pixutian/PingPong-Ball-Collector/docs/communication.md

# Communication Protocol · 蓝牙通信协议（v0.2）

> 本文描述 `firmware/Fusion_OpenCar` 在 UART2 上**实际解析**的协议。
> 厂家 App 的完整协议以其官方文档为准，本仓库不复制该文档。

---

## 1. 物理层

| 项目 | 参数 |
|---|---|
| 接口 | C30D USART2（`PD5` TX / `PD6` RX） |
| 波特率 | 9600 |
| 数据位/停止位/校验 | 8 / 1 / None |
| 模块 | JDY-33 / HC-02 兼容经典蓝牙 SPP |
| 手机侧 | 自研 App V3.2（推荐，本仓库开源）；厂家 App 仅兼容对照 |

手机与模块之间为 SPP 透传：App 发出的字节直接进入 `USART2_IRQHandler`，经 `module_noise_filter()`
丢弃模块提示文本后进入 `link_decode()`。

---

## 2. 下行指令

### 2.1 方向与功能（单字节 ASCII）

```c
g_link_dir = (uint8_t)(recv - 0x40);
```

| ASCII | 十六进制 | `g_link_dir` | 功能 | 左 / 右目标 |
|---|---|---|---|---|
| `A` | 0x41 | 1 | 前进 | `+Speed / +Speed` |
| `B` | 0x42 | 2 | 右前弧线 | `+1.5S / +0.75S` |
| `C` | 0x43 | 3 | 原地右转 | `+1.5S / −1.5S` |
| `D` | 0x44 | 4 | 右后弧线 | `−1.5S / −0.75S` |
| `E` | 0x45 | 5 | 后退 | `−Speed / −Speed` |
| `F` | 0x46 | 6 | 左后弧线 | `−0.75S / −1.5S` |
| `G` | 0x47 | 7 | 原地左转 | `−1.5S / +1.5S` |
| `H` | 0x48 | 8 | 左前弧线 | `+0.75S / +1.5S` |
| `S` | 0x53 | 19 | **停止**（落入 `default`） | `0 / 0` |

`S`、换行、空格或任何非方向字节都会进入 `switch` 的 `default`，四轮目标清零；**叶片保持原速**。

### 2.2 档位键（带 200 ms 去抖）

| ASCII | 十六进制 | 功能 | 说明 |
|---|---|---|---|
| `X` | 0x58 | 底盘升档 | `chassis_gear_change(+1)` |
| `Y` | 0x59 | 底盘降档 | `chassis_gear_change(−1)` |
| `T` | 0x54 | 叶片升档 | `aux_gear_change(+1)` |
| `U` | 0x55 | 叶片降档 | `aux_gear_change(−1)` |

`GEAR_KEY_DEBOUNCE_MS = 200`：两次按键间隔小于 200 ms 时，后一次被忽略。
上位机若按住连发，请把发送间隔设在 **≥250 ms**。

### 2.3 底盘档位表（7 档）

`SpeedSet = GEAR_BASE_RPM + (gear − 3) × 100`，`GEAR_BASE_RPM = 400`

| gear | 0 | 1 | 2 | 3 | 4 | 5 | 6 |
|---|---|---|---|---|---|---|---|
| 目标 r/min | 100 | 200 | 300 | **400** | 500 | 600 | 700 |

- 上电默认第 3 档（400 r/min）；
- `gear < 0` 或 `gear ≥ 7` 时回中间档 3。

### 2.4 叶片档位表（7 档，每档 5%）

`duty = AUX_GEAR_TOP_DUTY − (6 − gear) × 5`，最高 100%

| gear | 0 | 1 | 2 | 3 | 4 | 5 | 6 |
|---|---|---|---|---|---|---|---|
| 占空比 | 70% | 75% | 80% | **85%** | 90% | 95% | **100%** |

- 上电默认第 6 档（100%）；
- 越界回中间档 3（85%）；
- PWM：TIM8_CH1（PC6），ARR=9999，PSC=0，约 16.8 kHz；`CCR1 = duty × 100`。

### 2.5 页面切换（兼容厂家 App）

| 字符 | 作用 |
|---|---|
| `I` | 切换页面 0（重力球） |
| `J` | 切换页面 1（摇杆） |
| `K` | 切换页面 2（按键） |

这三个字节同时也会被 `g_link_dir = recv − 0x40` 赋值（9/10/11），落入 `default` 使底盘停止。
自研 App 不需要发送它们。

---

## 3. 状态回传

固件通过 `link_send_text()` 发送 ASCII 帧，`{` 开始、`$` 结束，字段用 `:` 分隔。

| 帧 | 格式 | 内容 | 发送时机 |
|---|---|---|---|
| A 类 | `{A%d:%d:%d:%d}$` | A 轮实测 RPM、B 轮实测 RPM、电量 %、航向角 | 主循环轮询 |
| B 类 | `{B%d:%d:%d}$` | 俯仰、横滚、航向 | 与 A 交替 |
| C 类 | `{C%d:%d}$` | 调试参数 1 / 2 | 收到 `{Q:P}` 或轮询 |
| D 类（可选） | `{D%d:%d}$` | 叶片占空比、底盘档位 | 需按补丁增加 |

> 帧没有校验和；解析时以 `$` 或换行为界。`{D}` 为可选扩展，补丁见 `firmware/README.md` 第 5.1 节。

---

## 4. 参数帧（兼容厂家 App）

| 帧 | 作用 |
|---|---|
| `{Q:P}` | 请求回传当前参数（触发 C 帧） |
| `{Q:W}` | 请求保存参数（当前仅置标志） |
| `{0:xxx}` / `{1:xxx}` | 设置调试参数 1 / 2 |
| `{#a:b:...}` | 一次下发多个参数（固件取前两个） |

参数帧以 `{` 开始、`}` 结束，帧内字节原样缓存。

---

## 5. 行为与安全

### 5.1 模块提示文本过滤

JDY-33 在连接/断开时会输出 `+CONNECTING<<MAC>\r\nCONNECTED\r\r\n`、`+DISC:SUCCESS\r\r\n`
等文本。固件用 `module_noise_filter()` 丢弃这些字节，否则其中的 `C`、`D` 等字符会被误判为方向。

### 5.2 没有通信超时停机（重要）

`g_link_dir` 只在收到新字节时改变。**蓝牙断开后，最后一次方向指令会一直保持，底盘继续运动。**
测试时保持手机与机器人可见；修复方向：在 5 ms 控制节拍中累加“指令年龄”，超过 500 ms 未收到
有效方向指令则四轮目标清零（叶片可延时停止）。

### 5.3 未知字节

非方向字节会改写 `g_link_dir`，通常落入 `default` 使底盘停止，但**不会停止叶片**。
不要依赖未知字节作为急停。

### 5.4 急停

- App 的“停止”按钮发送 `S`；
- 物理急停：断开电池或整车电源。
