pixutian/PingPong-Ball-Collector/docs/compatibility.md

# Compatibility · 软硬件兼容性

> **v0.2 更新**：固件改为 `Fusion_OpenCar` 完整工程，APP 升级为 V3.2（7 档车速 / 7 档叶片，每档 5%）。
>
> 本项目只在一个具体组合上完成过实车验证。下表区分“已验证”“理论兼容”“未验证”，
> 避免读者误以为可以自由混搭。

---

## 1. 已验证组合

| 层级 | 型号/版本 | 验证状态 |
|---|---|---|
| 底盘 | 淘宝购置的轮趣 R1 四驱小车底盘 | ✅ 实车运行 |
| 主控 | WHEELTEC C30D V2.2（STM32F407VET6） | ✅ 实车运行 |
| 底盘电机 | 4× WHEELTEC MG310P20 编码减速电机 | ✅ 原厂配套 |
| 编码器 | 霍尔，13 PPR，减速比 30 | ✅ 代码按 1560 计数/圈换算 |
| 电池 | 12 V 2550 mAh 锂电池 | ✅ 原厂配套 |
| 蓝牙 | JDY-33 兼容 SPP 模块，9600 | ✅ 厂家 App 实车 |
| 叶片驱动 | TB6612FNG + 5 V 直流减速电机 | ✅ 实车 |
| 显示 | 0.96" OLED（C30D 套件） | ✅ 实车 |
| 固件 | `firmware/Fusion_OpenCar`（完整 Keil 工程，v0.2） | ✅ 实车 |
| 厂家 App | WHEELTEC 配套蓝牙 App | ✅ 比赛使用 |
| 自研 App | 收集车控制台 **V3.2**（`com.pxt.carcontrol`，7 档车速/叶片） | ✅ 基本遥控验证 |

---

## 2. 版本与兼容性矩阵

### 2.1 主控板

| 主控 | 兼容性 | 说明 |
|---|---|---|
| C30D V2.2 | ✅ 已验证 | 本项目目标板 |
| C30D V2.1 | ⚠️ 可能兼容 | 原理图/资源分配接近，但引脚与驱动可能不同，需逐项核对 |
| C30D V2.0 | ⚠️ 未验证 | 厂家基础例程版本不同，不能直接套用 |
| 其他 STM32F407 板 | ❌ 不保证 | 电机驱动、编码器、OLED、蓝牙接口都需重做 |

### 2.2 底盘

| 底盘 | 兼容性 | 说明 |
|---|---|---|
| R1 四驱（淘宝购置） | ✅ 已验证 | 实车 4× MG310P20，四轮差速 |
| R1 其他批次 / 其他轮趣底盘 | ⚠️ 未验证 | 电机、减速比、轮径可能不同 |
| 其他四驱底盘 | ⚠️ 需改代码 | 需重新确认 M1–M4、编码器符号、减速比、轮径 |

### 2.3 蓝牙模块

| 模块 | 兼容性 | 说明 |
|---|---|---|
| JDY-33 兼容 SPP | ✅ 已验证 | 厂家 BSP 含 JDY-33 AT 反馈过滤 |
| HC-05 / HC-06 | ⚠️ 可能兼容 | SPP 透传可用，但 AT 反馈过滤不同；需实测 |
| BLE 模块（非 SPP） | ❌ 不兼容 | 当前固件/自研 App 使用经典蓝牙 SPP |

### 2.4 手机 App

| App | 兼容性 | 说明 |
|---|---|---|
| 厂家蓝牙 App | ✅ 兼容对照 | 仅用于对照，不在本仓库；本项目开源的是自研 App |
| 自研 App V3.2 | ✅ 推荐用于本项目 | Android 6.0+；圆盘 + 7 档车速/叶片 + 遥测；无断线重连 |
| 其他串口 App | ⚠️ 需匹配 | 发送 ASCII `A`–`H`/`S`/`T`/`U`/`X`/`Y` 即可；不要自动追加回车；档位键间隔 ≥250 ms |

### 2.5 固件基线

| 基线 | 兼容性 | 说明 |
|---|---|---|
| `Fusion_OpenCar`（本仓库完整工程） | ✅ 本项目固件 | 不依赖厂家示例；`Driver/` 为 ST 标准库 |
| 其他厂家示例（FreeRTOS/雷达版） | ❌ 不直接兼容 | 任务结构、BSP、引脚不同 |
| 其他厂家示例工程 | ⚠️ 需移植 | 引脚、BSP、任务结构不同，不能直接套用 |

---

## 3. 自研 Android App 兼容性

| 项目 | 值 |
|---|---|
| 应用名 | 蓝牙串口助手 |
| 包名 | `com.example.hc02serial` |
| 版本 | 1.0（versionCode 1），debug 构建 |
| 最低系统 | Android 6.0（API 23） |
| 编译/目标 | API 35（Android 15） |
| 权限 | `BLUETOOTH_CONNECT`（Android 12+ 运行时）；`BLUETOOTH`/`BLUETOOTH_ADMIN`（≤API 30） |
| 通信 | 经典蓝牙 SPP，UUID `00001101-0000-1000-8000-00805F9B34FB` |
| 设备发现 | 不做扫描，读取系统已配对设备 |
| 已知限制 | debug 构建、`com.example` 包名、无断线重连/心跳/发送队列 |

> 发布正式版前应：关闭 `debuggable`/`allowBackup`，配置正式签名，改包名，
> 增加重连与指令校验。详见 [app/README.md](../app/README.md)。

---

## 4. 未验证/不支持的场景

- **视觉识别、ROS 2、SLAM、自主导航**：当前固件没有这些功能，也没有预留接口。
- **>10 个球/更复杂场地**：没有系统测试数据；机构可能卡球或漏球。
- **斜坡/地毯/湿滑地面**：四轮差速与 PI 参数按平地整定，未验证。
- **长时间连续运行**：叶片电机与 TB6612 的温升未做长时间测试。
- **不同批次 R1/C30D**：厂家可能更改电机、编码器、接口定义；必须实测。

---

## 5. 兼容性检查清单

复现前请逐项确认：

- [ ] 底盘型号与电机铭牌（MG310P20？减速比 30？）
- [ ] 主控版本（C30D V2.2？STM32F407VET6？）
- [ ] 编码器线数（13 PPR？霍尔？）
- [ ] 电池电压（12 V？）
- [ ] 蓝牙模块（JDY-33 兼容？9600？）
- [ ] 叶片电机电压（5 V？不要接 12 V）
- [ ] TB6612 引脚定义（PWMA/AIN1/AIN2/STBY/VM）
- [ ] 手机系统版本与蓝牙权限
- [ ] 厂家 App 版本与协议

如果任何一项不同，请先降级到“只测试底盘”，再逐步接入收球机构。
