pixutian/PingPong-Ball-Collector/firmware/Fusion_OpenCar/Driver/NOTICE-ST.md

# STM32F4 标准外设库声明 / ST Notice

`Driver/StdPeriph/` 为 ST 的 **STM32F4 标准外设库**，版权归 STMicroelectronics（MCD Application Team），
按 **SLA0044（Software License Agreement, Rev5/February 2018）** 使用与再分发，全文见 `LICENSE-ST.txt`。

`Driver/CMSIS/` 为 **CMSIS 内核与设备头文件**，版权归 ARM Limited / STMicroelectronics，
按 **Apache License 2.0** 授权，全文见 `LICENSE-CMSIS.txt`。

- 这些文件为**原样保留**，用于在本仓库内直接编译 `Fusion_OpenCar` 工程。
- 本项目不声明对其拥有版权；原始版权头保留在各文件顶部。
- 许可全文：`LICENSE-ST.txt`（StdPeriph，SLA0044 Rev5/February 2018）、`LICENSE-CMSIS.txt`（CMSIS，Apache-2.0）
- 如再分发本仓库，请保留本声明与各源文件中的版权头。

The files under `Driver/CMSIS/` and `Driver/StdPeriph/` are copyright
**STMicroelectronics** (MCD Application Team) and are distributed under the
**SLA0044 Software License Agreement** (full text in `LICENSE-ST.txt`); CMSIS files are under **Apache License 2.0** (`LICENSE-CMSIS.txt`). They are kept unmodified so that the
`Fusion_OpenCar` project can build in-tree. This project claims no copyright over
them; original headers are preserved. See ST's official terms:
<https://www.st.com/software-license-agreement>.
