pixutian/PingPong-Ball-Collector/media/exploded-view.png

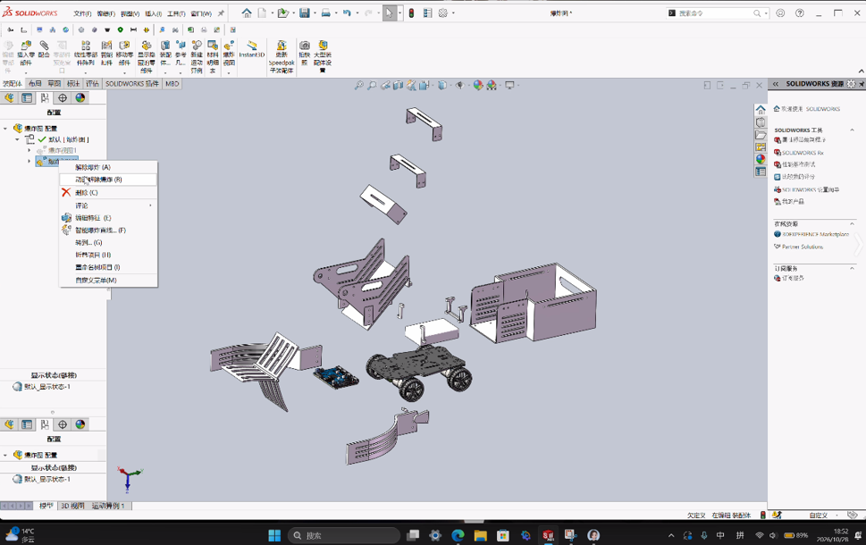
media/exploded-view.png
