pixutian/PingPong-Ball-Collector/media/robot-workbench.jpg

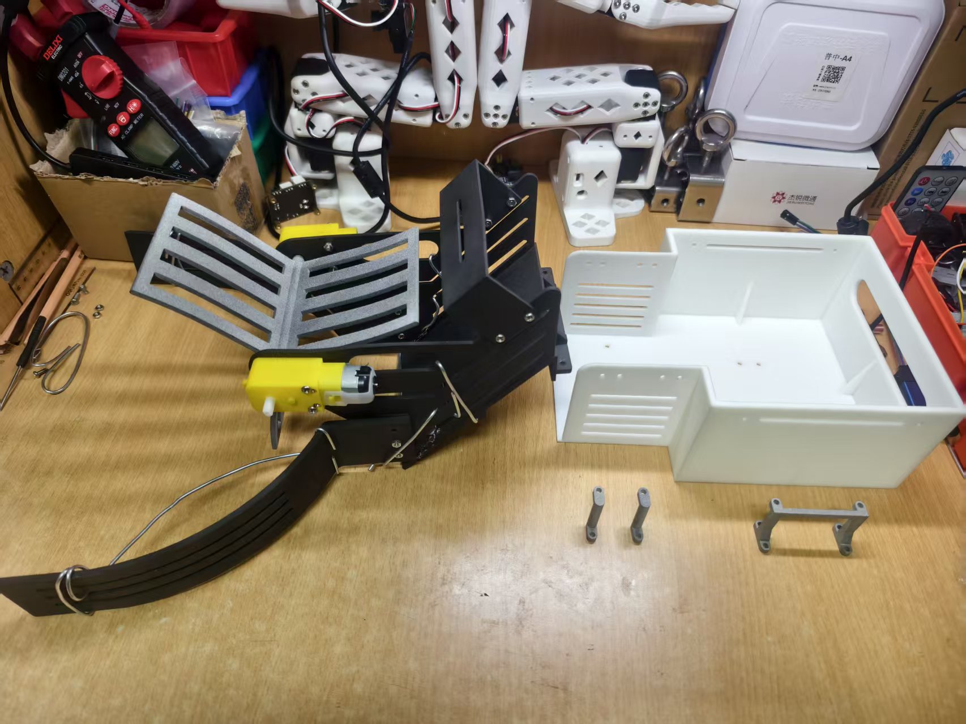
media/robot-workbench.jpg
