pixutian/PingPong-Ball-Collector/media/robot.jpg

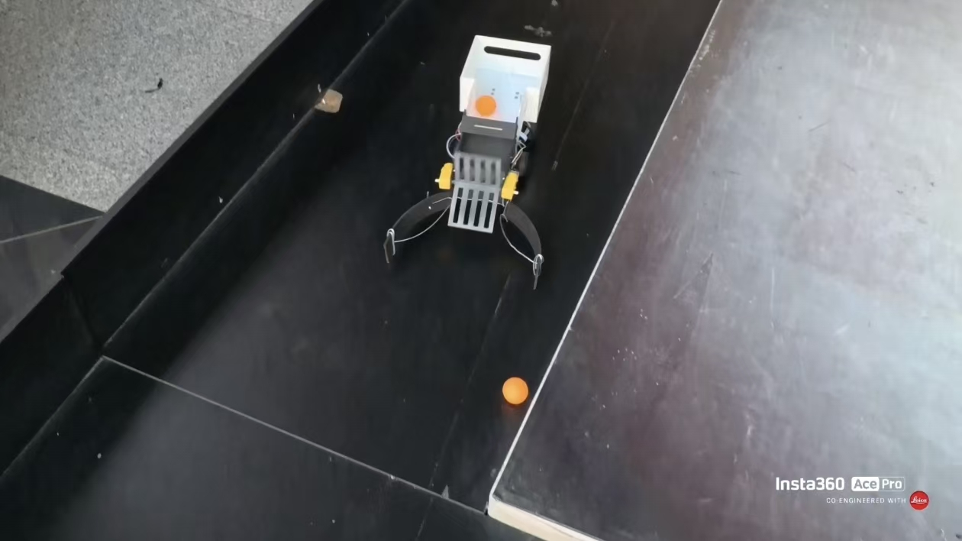
media/robot.jpg
