pixutian/PingPong-Ball-Collector/hardware/BOM.csv

类别 | 项目 | 型号/规格 | 数量 | 单位 | 单价(CNY) | 小计(CNY) | 来源 | 来源类型 | 备注
移动平台 | R1 四驱小车底盘（淘宝购置） | WHEELTEC R1 | 1 | 套 |  |  | WHEELTEC | 第三方 | 含底盘板、轮组、紧固件；实车电机为4×MG310P20编码减速电机；价格以厂家为准
主控 | 驱控一体主控板 | C30D V2.2 / STM32F407VET6 | 1 | 块 |  |  | WHEELTEC | 第三方 | 集成4路底盘驱动、OLED、IMU、ADC；非本项目PCB
电源 | 12V锂电池 | 12V 2550mAh | 1 | 块 |  |  | WHEELTEC | 第三方 | 随套件/以厂家为准
通信 | 蓝牙SPP模块 | JDY-33兼容 | 1 | 个 |  |  | WHEELTEC/第三方 | 第三方 | UART2 9600；实物型号请核对
显示 | OLED | 0.96英寸 I2C | 1 | 个 |  |  | WHEELTEC | 第三方 | 随C30D套件
执行器 | 叶片驱动电机 | 5V直流减速电机 | 1 | 个 |  |  | 淘宝/通用 | 第三方 | 具体型号待补；不可直接用12V
驱动 | TB6612FNG电机驱动板 | 焊好排针 | 2 | 块 | 6.15 | 12.3 | 淘宝·欣薇电子企业店 | 第三方 | 1用1备
运费 | — | — | 1 | 笔 | 2.5 | 2.5 | 淘宝·欣薇电子企业店 | 第三方
轴承 | 深沟球轴承 | 605ZZ 5×11×5 | 1 | 个 | 2.46 | 2.46 | 淘宝·xundazc五金旗舰店 | 第三方 | 自由端支承
紧固件 | M3×6 机丝 | 304不锈钢圆头 | 200 | 只 | 4.57 | 4.57 | 淘宝·固万基 | 第三方 | 整包；装配用量约36套
紧固件 | M3×7 机丝 | 304不锈钢圆头 | 200 | 只 | 5.12 | 5.12 | 淘宝·固万基 | 第三方 | 整包
紧固件 | M3×8 机丝 | 304不锈钢圆头 | 200 | 只 | 5.09 | 5.09 | 淘宝·固万基 | 第三方 | 整包
紧固件 | M3×9 机丝 | 304不锈钢圆头 | 200 | 只 | 7.9 | 7.9 | 淘宝·固万基 | 第三方 | 整包
紧固件 | M3×10 机丝 | 304不锈钢圆头 | 200 | 只 | 5.7 | 5.7 | 淘宝·固万基 | 第三方 | 整包
紧固件 | M3×12 机丝 | 304不锈钢圆头 | 100 | 只 | 3.38 | 3.38 | 淘宝·固万基 | 第三方 | 整包
紧固件 | M3×25 机丝 | 304不锈钢圆头 | 100 | 只 | 5.24 | 5.24 | 淘宝·固万基 | 第三方 | 整包
紧固件 | M3螺母 | 304不锈钢六角 | 400 | 只 | 3.8 | 7.6 | 淘宝·固万基 | 第三方 | 2包×200
辅材 | 镀锌铁丝13号 | 2.5mm，约10m | 1 | 卷 | 5.67 | 5.67 | 淘宝·轩颖金属线材 | 第三方 | 现场固定/加强
辅材 | 镀锌铁丝14号 | 2.2mm，约14m | 1 | 卷 | 5.2 | 5.2 | 淘宝·轩颖金属线材 | 第三方 | 现场固定/加强
辅材 | 尼龙扎带 | 4×350，白/黑各100 | 2 | 包 | 5.54 | 11.08 | 淘宝·jts家居旗舰店 | 第三方
运费 | — | — | 1 | 笔 | 1.5 | 1.5 | 淘宝·jts家居旗舰店 | 第三方
3D打印 | 车前端 front-housing | 3201PA-F，灰黑 | 1 | 件 | 120.64 | 120.64 | 嘉立创 | 自制
3D打印 | 后备箱 storage-bin | 9600哑光白，打磨-粗磨 | 1 | 件 | 127.01 | 127.01 | 嘉立创 | 自制
3D打印 | 叶片 blade | PA12，灰黑 | 1 | 组 | 70.6 | 70.6 | 嘉立创 | 自制 | 三叶
3D打印 | 左爪 left-claw | 3201PA-F，灰黑 | 1 | 件 | 55.17 | 55.17 | 嘉立创 | 自制
3D打印 | 右爪 right-claw | 3201PA-F，灰黑 | 1 | 件 |  |  | 嘉立创 | 自制 | 镜像件；报价待确认，未计入合计
3D打印 | 叶片轴 blade-shaft | BJ-316L不锈钢 | 1 | 件 | 10.0 | 10.0 | 嘉立创 | 自制
3D打印 | 拱顶 arch-cover | 3201PA-F，灰黑 | 2 | 件 | 5.14 | 10.28 | 嘉立创 | 自制 | 比赛样机未全部装车
3D打印 | 盒盖 bearing-cover | PA12，灰黑 | 1 | 件 | 5.15 | 5.15 | 嘉立创 | 自制 | 比赛样机未装车
3D打印 | 双支架 double-bracket | PA12，灰黑 | 1 | 组 | 5.49 | 5.49 | 嘉立创 | 自制
3D打印 | 单支架 single-bracket | PA12，灰黑 | 2 | 件 | 4.87 | 9.74 | 嘉立创 | 自制
3D打印 | 前挡顶 front-top-guard | PA12/PA-F | 1 | 件 |  |  | 嘉立创 | 自制 | 报价待确认，未计入合计
3D打印 | 地板 floor-panel | 板材/打印 | 1 | 件 |  |  | 自制 | 自制 | 仅SLDPRT，STL待补；未计入合计
合计 | 已验证的补充采购与加工支出 | — | — | — |  | 499.39 | — | — | 不含底盘、主控、电池、电机等厂家套件；不含未报价件
