pixutian/PingPong-Ball-Collector/hardware/cad/source/arch-cover.SLDPRT

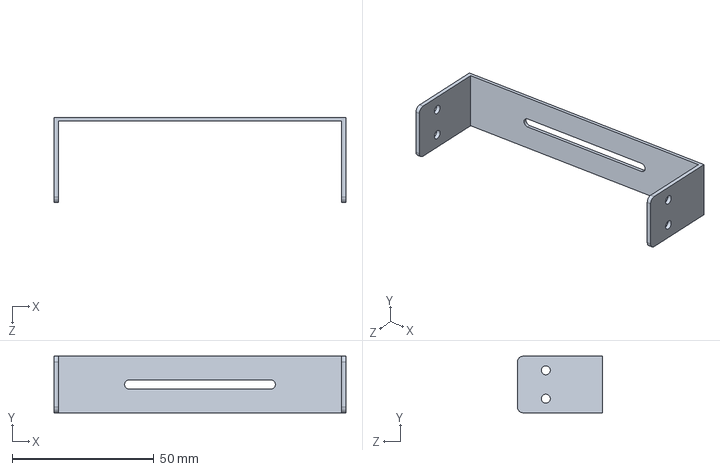
[picture p7: CAD file, 2026-11-07]
hardware/cad/source/arch-cover.SLDPRT
103.0 x 20.0 x 30.0 mm
