pixutian/PingPong-Ball-Collector/hardware/cad/source/storage-bin.SLDPRT

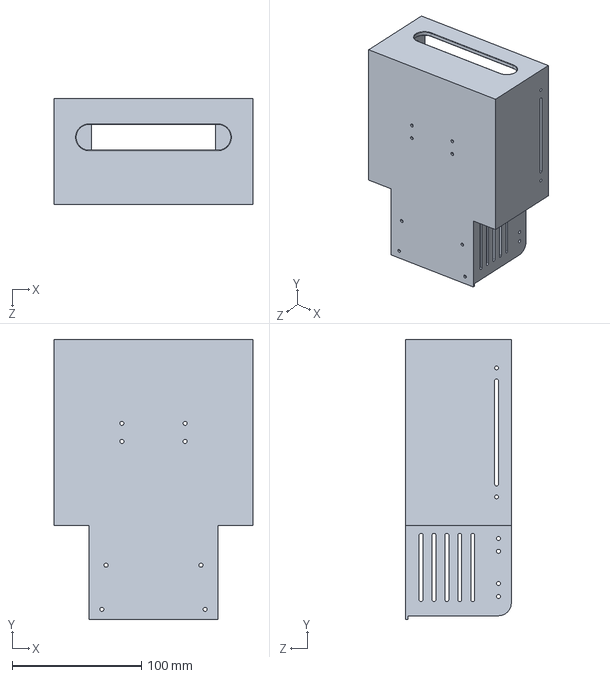
[picture p8: CAD file, 2026-11-07]
hardware/cad/source/storage-bin.SLDPRT
154.0 x 217.0 x 82.0 mm
