pixutian/PingPong-Ball-Collector/hardware/cad/source/bearing-cover.SLDPRT

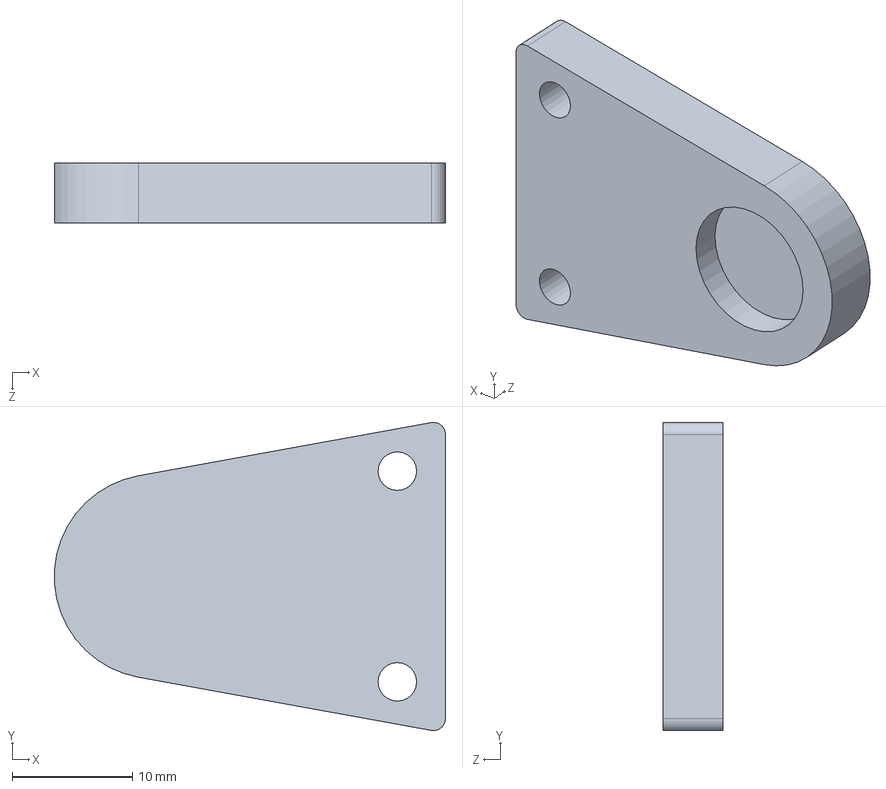
[picture p9: CAD file, 2026-11-07]
hardware/cad/source/bearing-cover.SLDPRT
32.5 x 25.6 x 5.00 mm
