pixutian/PingPong-Ball-Collector/hardware/cad/source/single-bracket.SLDPRT

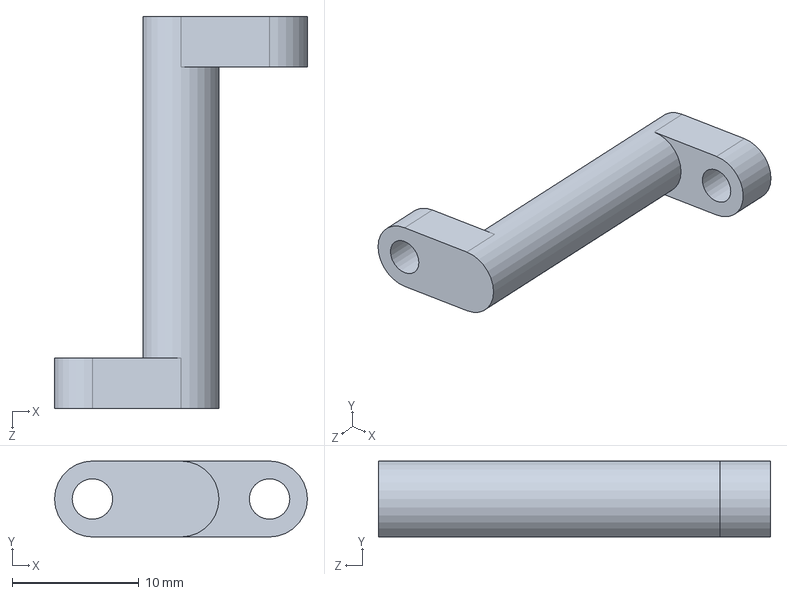
[picture p10: CAD file, 2026-11-07]
hardware/cad/source/single-bracket.SLDPRT
20.0 x 6.00 x 31.0 mm
