pixutian/PingPong-Ball-Collector/hardware/cad/source/front-housing.SLDPRT

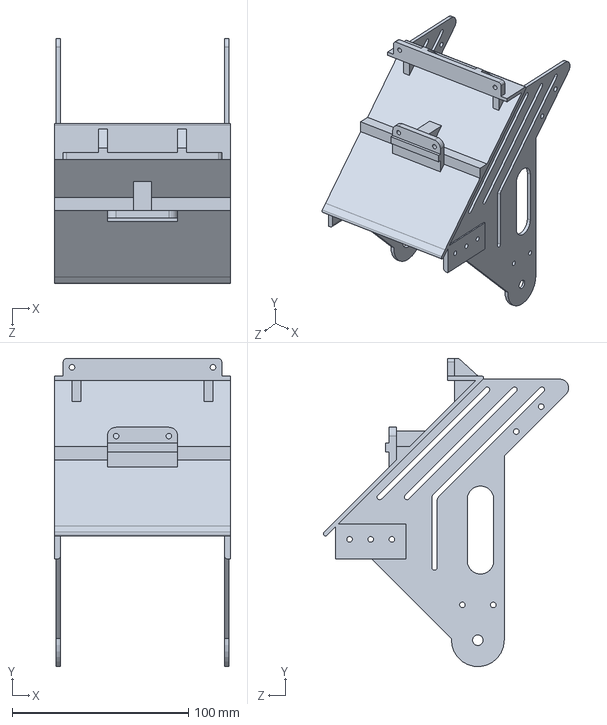
[picture p11: CAD file, 2026-11-07]
hardware/cad/source/front-housing.SLDPRT
100.0 x 174.8 x 139.2 mm
