pixutian/PingPong-Ball-Collector/hardware/cad/source/blade-shaft.SLDPRT

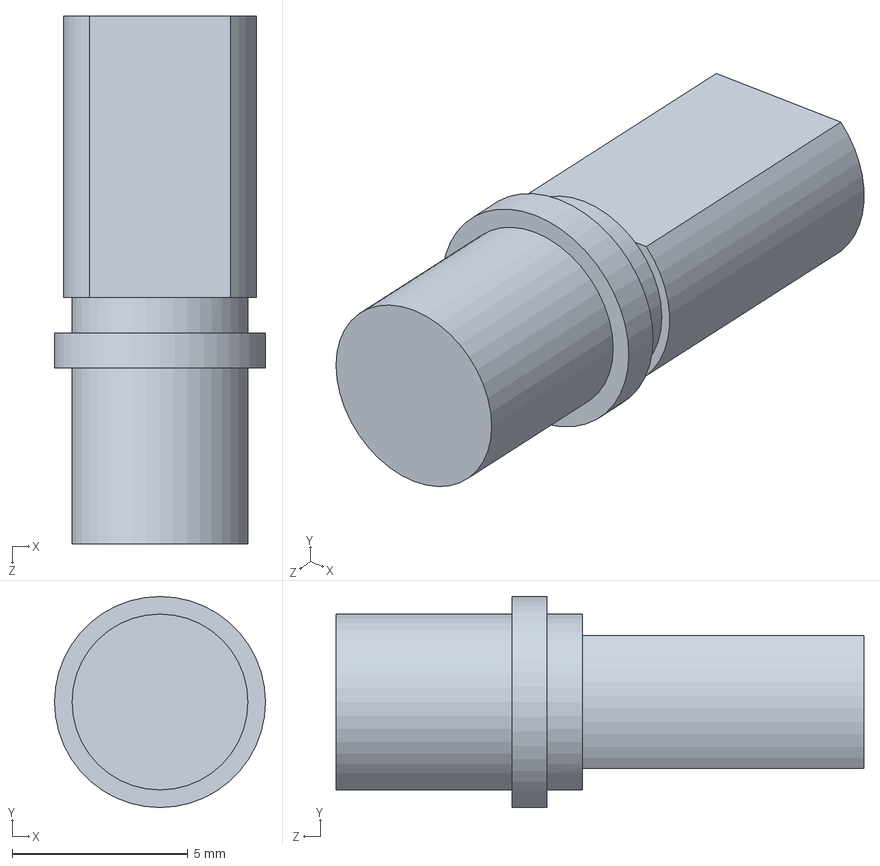
[picture p12: CAD file, 2026-11-07]
hardware/cad/source/blade-shaft.SLDPRT
6.00 x 6.00 x 15.0 mm
