pixutian/PingPong-Ball-Collector/hardware/cad/source/front-top-guard.SLDPRT

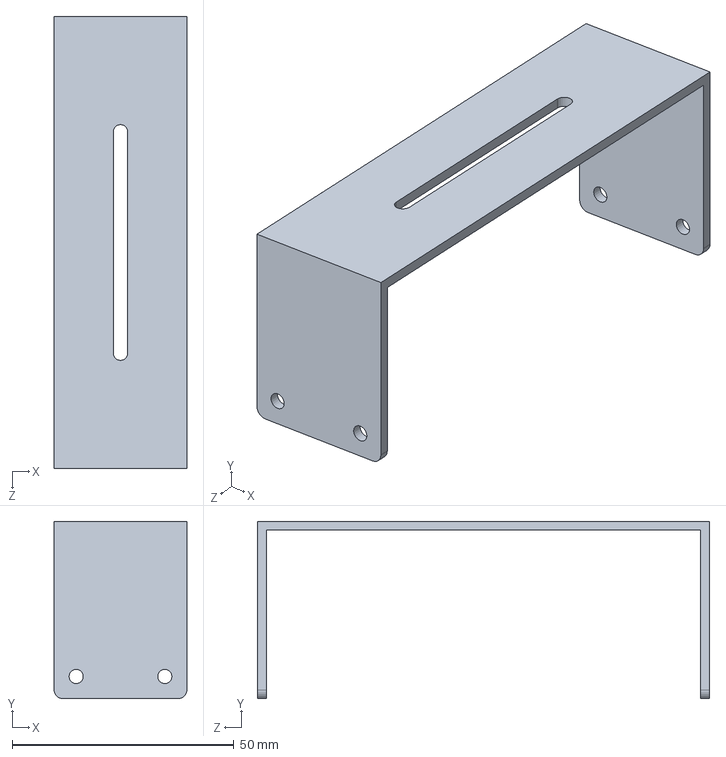
[picture p13: CAD file, 2026-11-07]
hardware/cad/source/front-top-guard.SLDPRT
30.0 x 40.0 x 102.0 mm
