pixutian/PingPong-Ball-Collector/hardware/cad/source/blade.SLDPRT

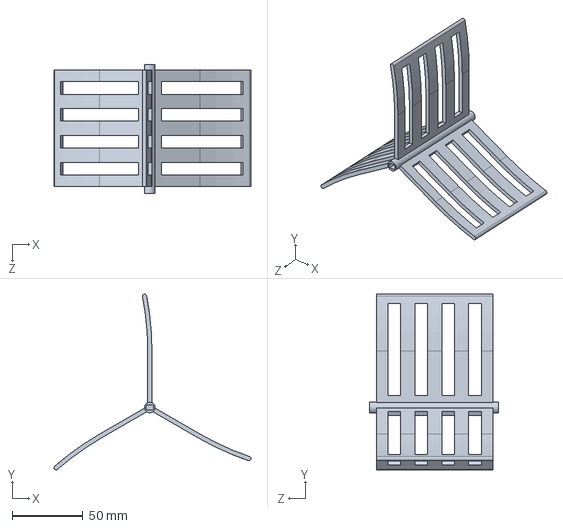
[picture p14: CAD file, 2026-11-07]
hardware/cad/source/blade.SLDPRT
139.0 x 124.0 x 91.0 mm
