pixutian/PingPong-Ball-Collector/hardware/cad/source/floor-panel.SLDPRT

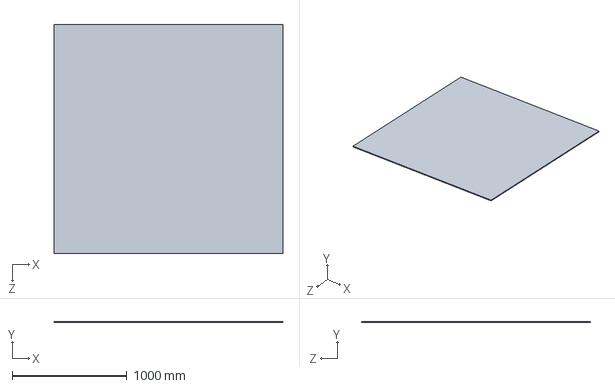
[picture p15: CAD file, 2026-11-07]
hardware/cad/source/floor-panel.SLDPRT
2000.0 x 10.0 x 2000.0 mm
