pixutian/PingPong-Ball-Collector/hardware/cad/source/left-claw.SLDPRT

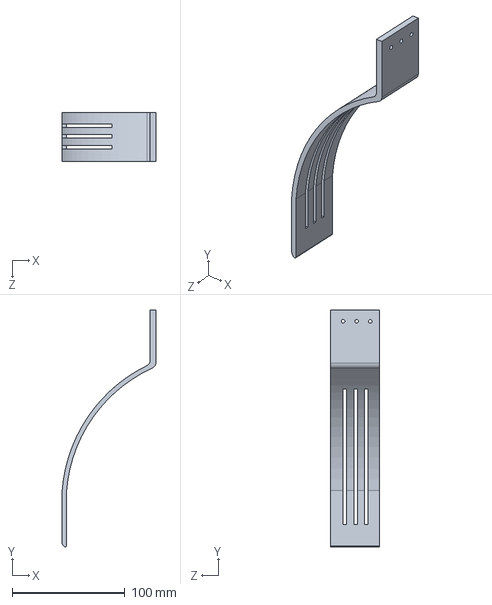
[picture p16: CAD file, 2026-11-07]
hardware/cad/source/left-claw.SLDPRT
83.0 x 209.8 x 43.0 mm
