pixutian/PingPong-Ball-Collector/hardware/cad/source/double-bracket.SLDPRT

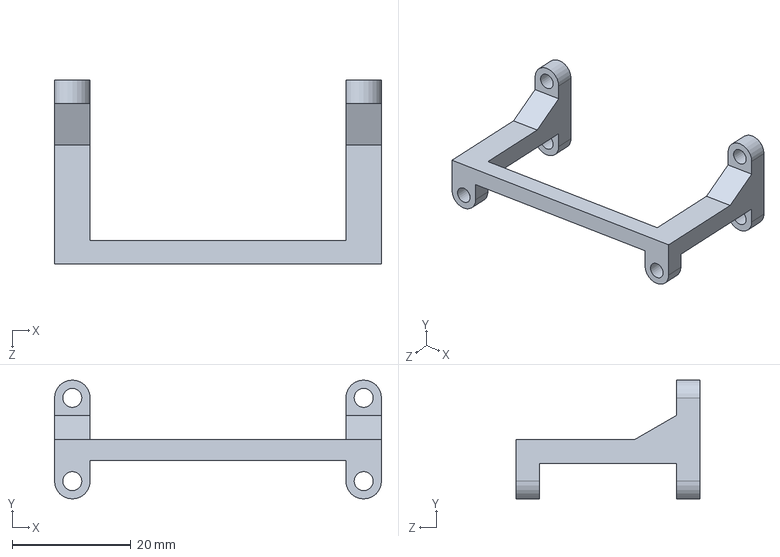
[picture p17: CAD file, 2026-11-07]
hardware/cad/source/double-bracket.SLDPRT
55.0 x 20.0 x 31.0 mm
