pixutian/PingPong-Ball-Collector/(list of files, cad)

Other CAD files:
hardware/cad/source/right-claw.SLDPRT
hardware/cad/stl/arch-cover.STL
hardware/cad/stl/bearing-cover.STL
hardware/cad/stl/blade-shaft.STL
hardware/cad/stl/blade.STL
hardware/cad/stl/double-bracket.STL
hardware/cad/stl/front-housing.STL
hardware/cad/stl/front-top-guard.STL
hardware/cad/stl/left-claw.STL
hardware/cad/stl/right-claw.STL
hardware/cad/stl/single-bracket.STL
hardware/cad/stl/storage-bin.STL
