pixutian/PingPong-Ball-Collector/media/assembly-drawing.png

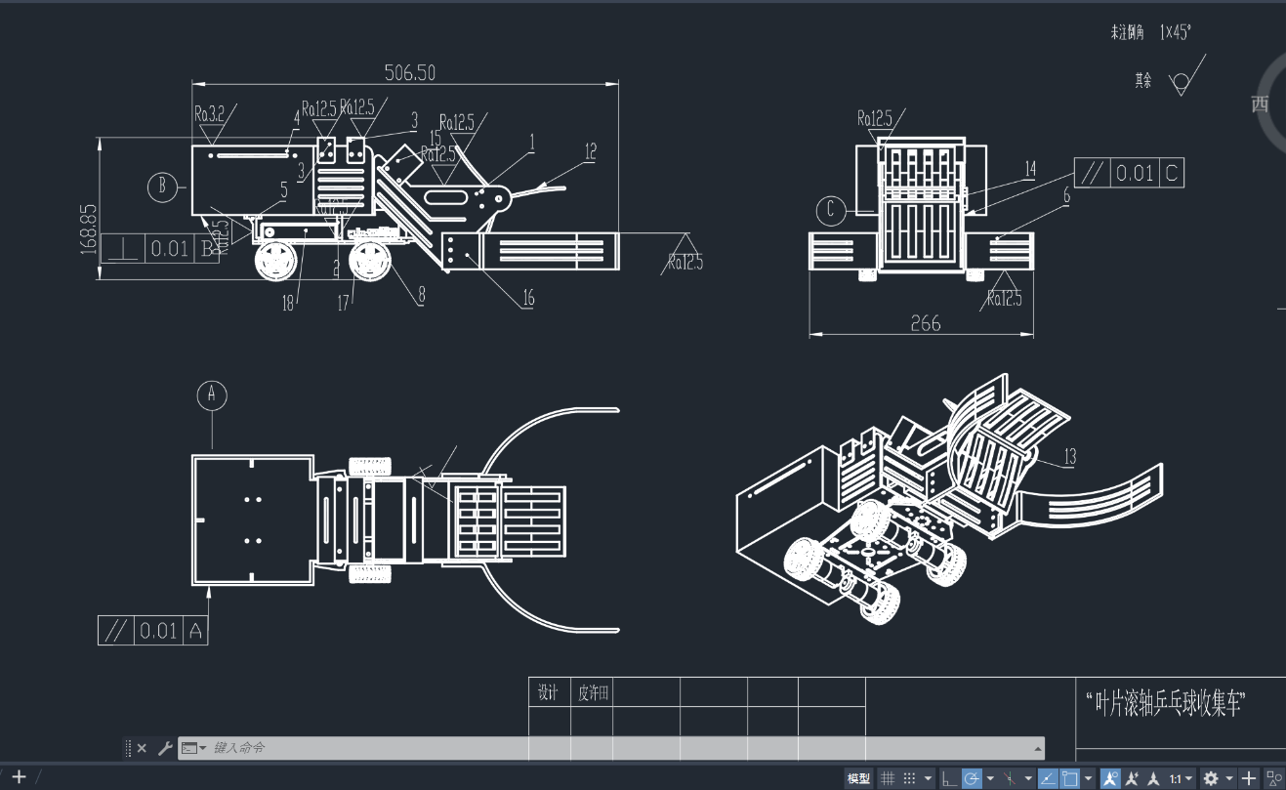
media/assembly-drawing.png
