pixutian/PingPong-Ball-Collector/media/assembly.png

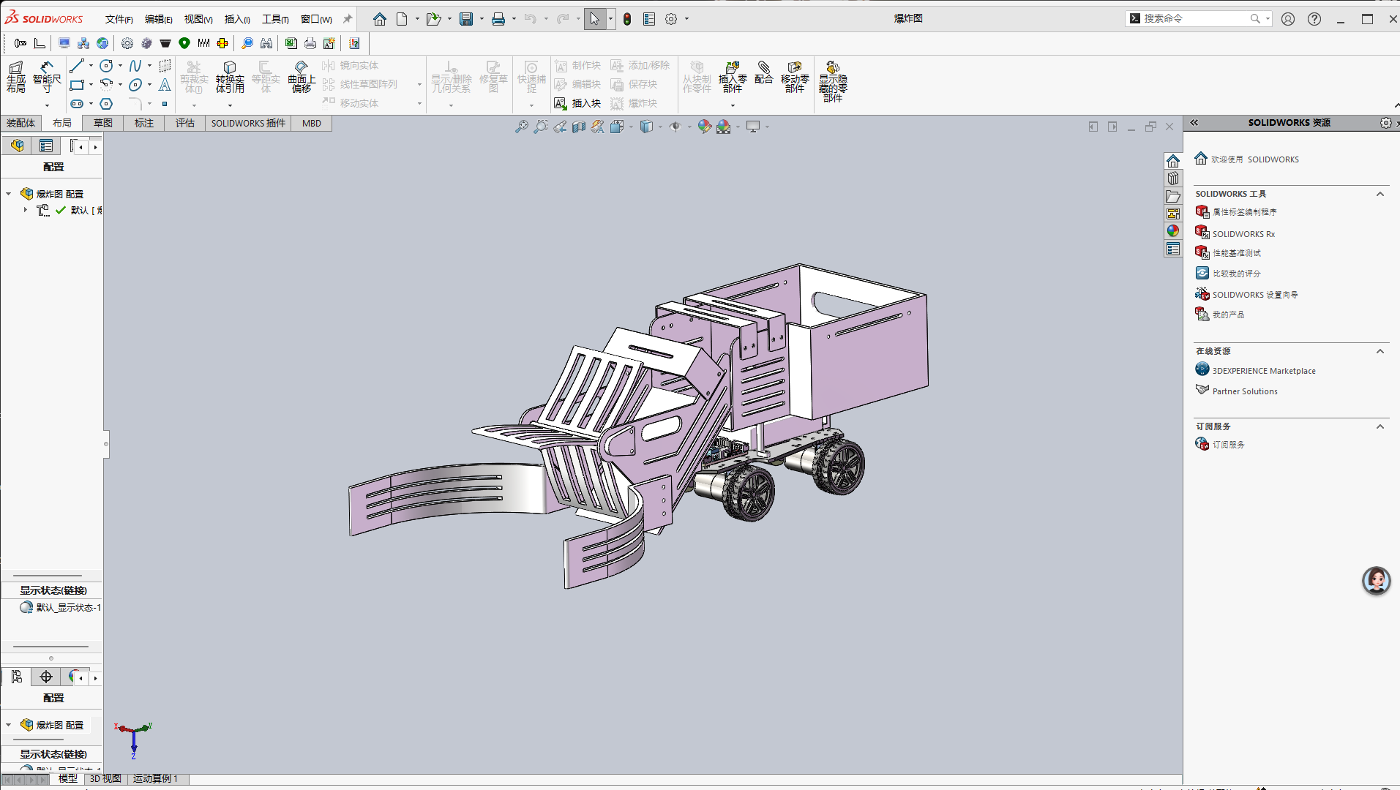
media/assembly.png
