pixutian/PingPong-Ball-Collector/media/wiring-diagram.png

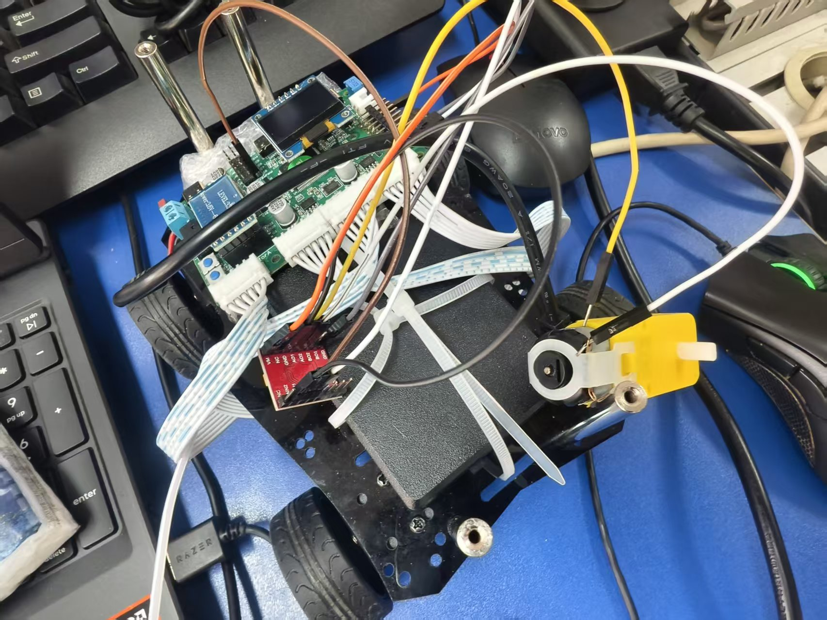
media/wiring-diagram.png
