pixutian/PingPong-Ball-Collector/media/wiring-photo.png

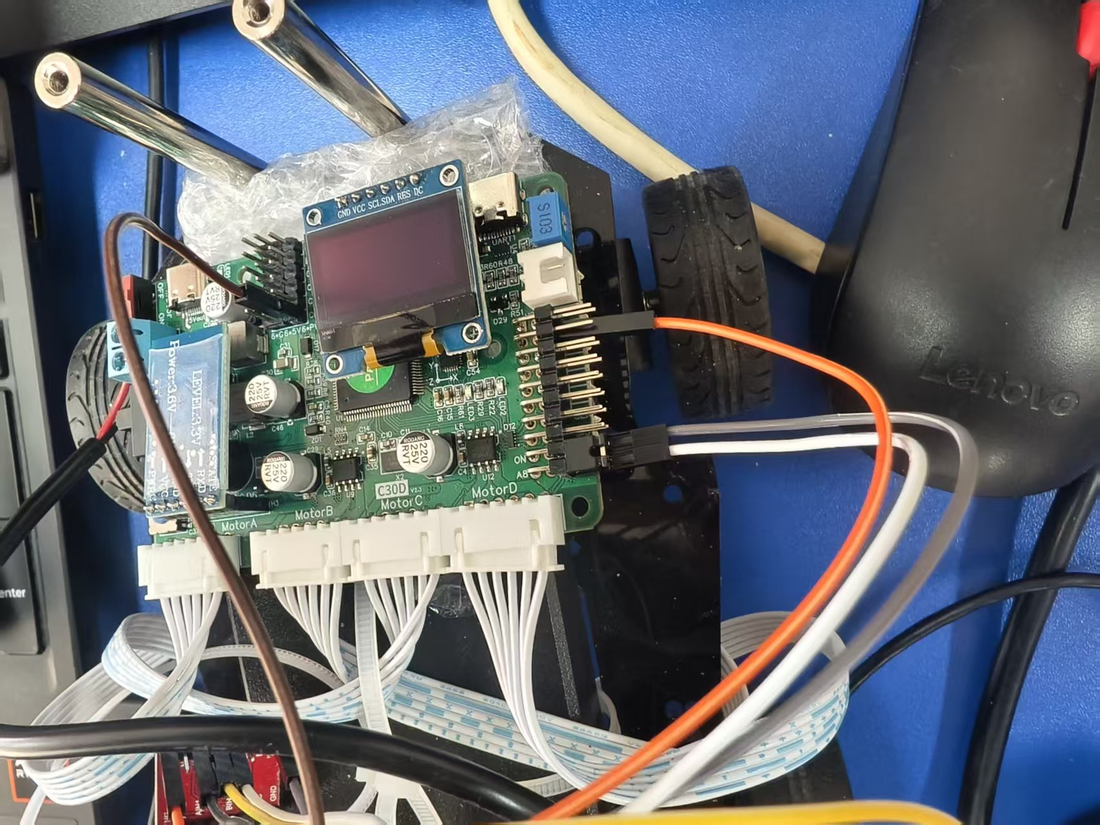
media/wiring-photo.png
