pixutian/PingPong-Ball-Collector/media/issue-jam.jpg

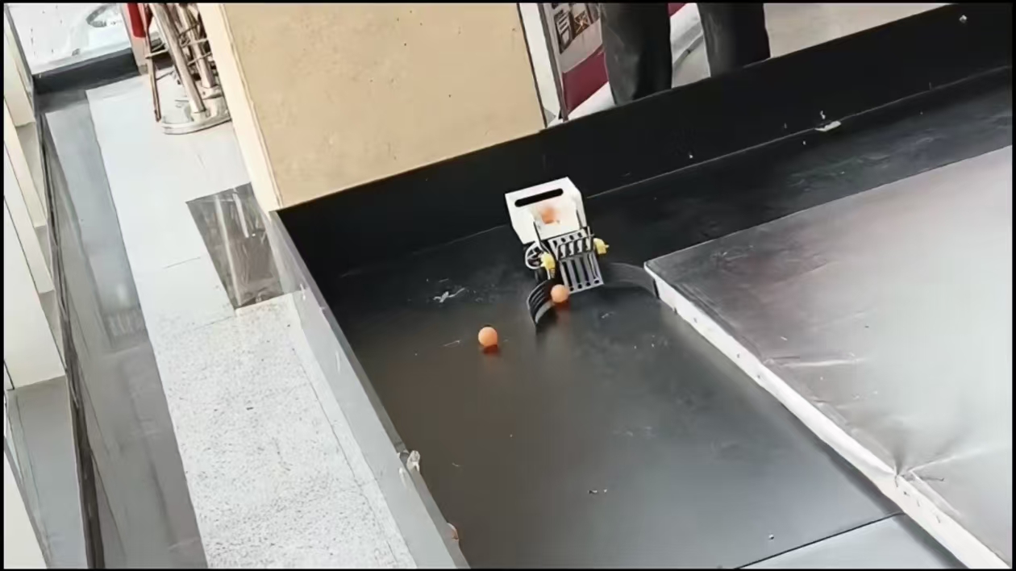
media/issue-jam.jpg
