pixutian/PingPong-Ball-Collector/(commit log)

2026-11-07 v0.2.0: remote-controlled ping-pong collector (firmware + Android console + docs)
    Includes Fusion_OpenCar firmware, Android console V3.2 (source + APK), bilingual README, docs, hardware CAD/STL, and third-party license notices.
    [BOM.csv, arch-cover.SLDPRT, arch-cover.STL, bearing-cover.SLDPRT, bearing-cover.STL, blade-shaft.SLDPRT, blade-shaft.STL, blade.SLDPRT]
2026-11-07 新增实地测试实拍图
2026-11-07 增加实地测试现场图片
